Sashkoiv/candleLight_fw/hw/Doc1.pdf

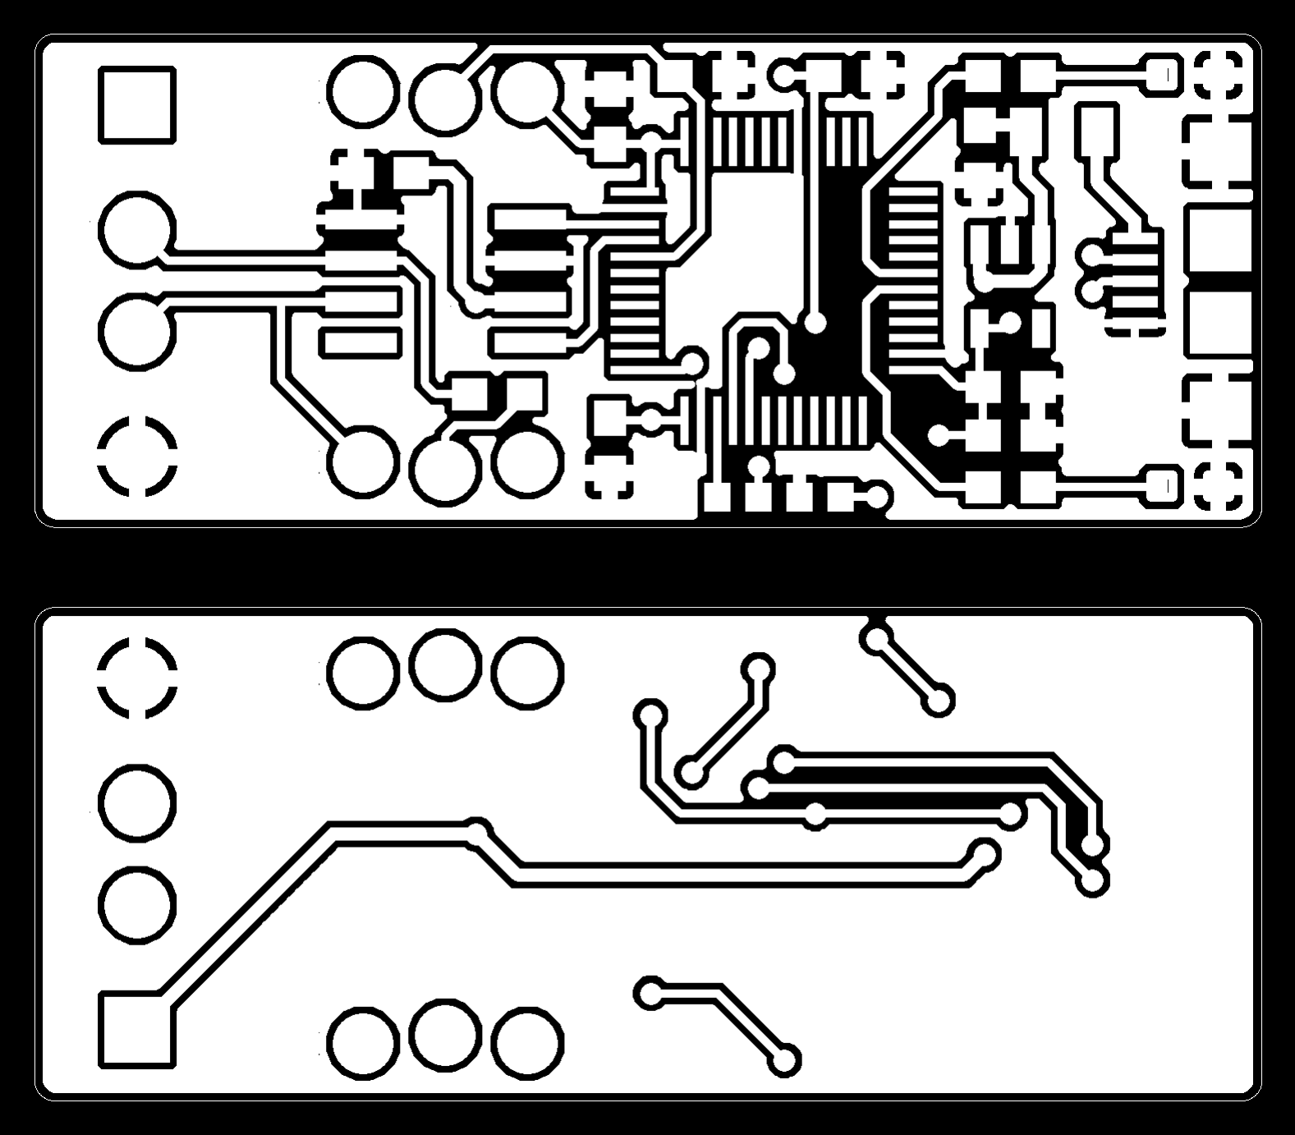
[picture p1: figure]
