Sashkoiv/candleLight_fw/hw/canable.bmp

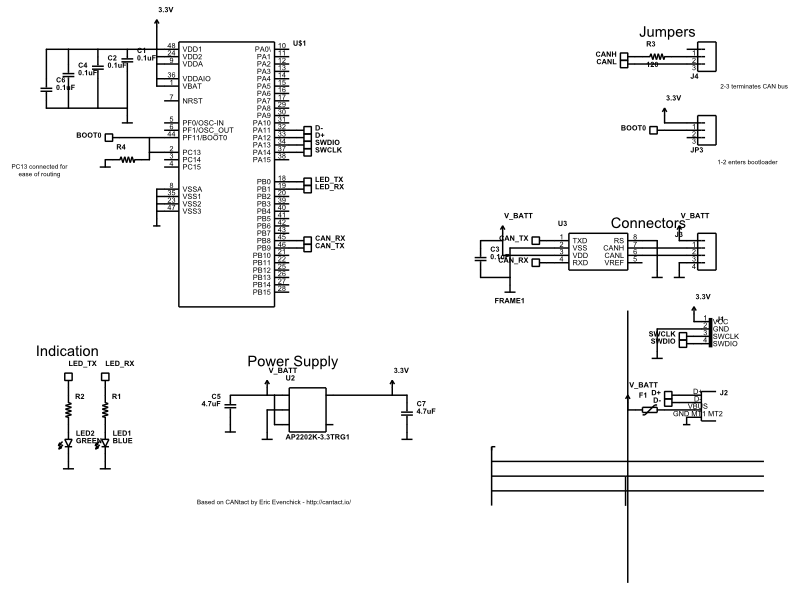
hw/canable.bmp
