Sashkoiv/candleLight_fw/(list of files, drawings)

Other design files:
hw/canable(imported)/canable.PcbDoc
hw/canable(imported)/canable.PrjPcb
hw/canable(imported)/canable.SchDoc
hw/canable(imported)/canable.SchDoc_Template.SchDoc
