Sashkoiv/candleLight_fw/hw/assembly.bmp

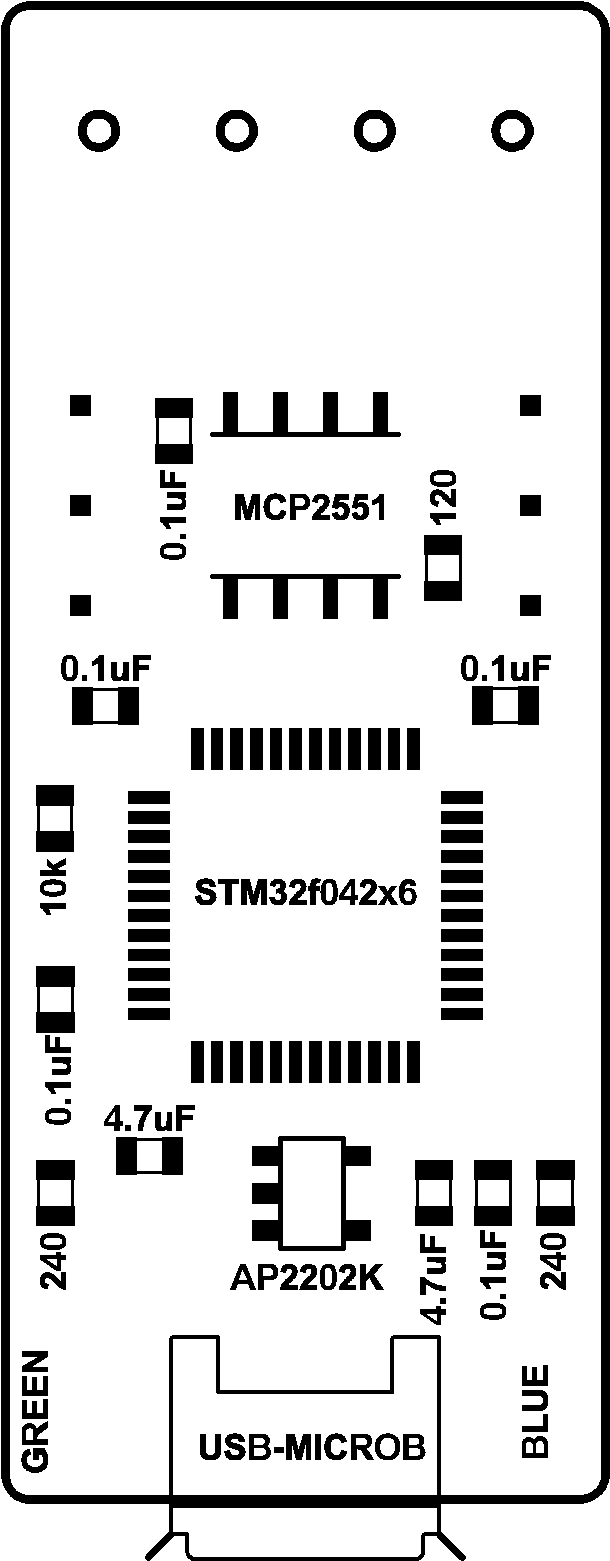
hw/assembly.bmp
